arminesweeper/Minesweeper2026/Minesweeper2026/Files/Schematic/IMG-20260618-WA0007.jpg

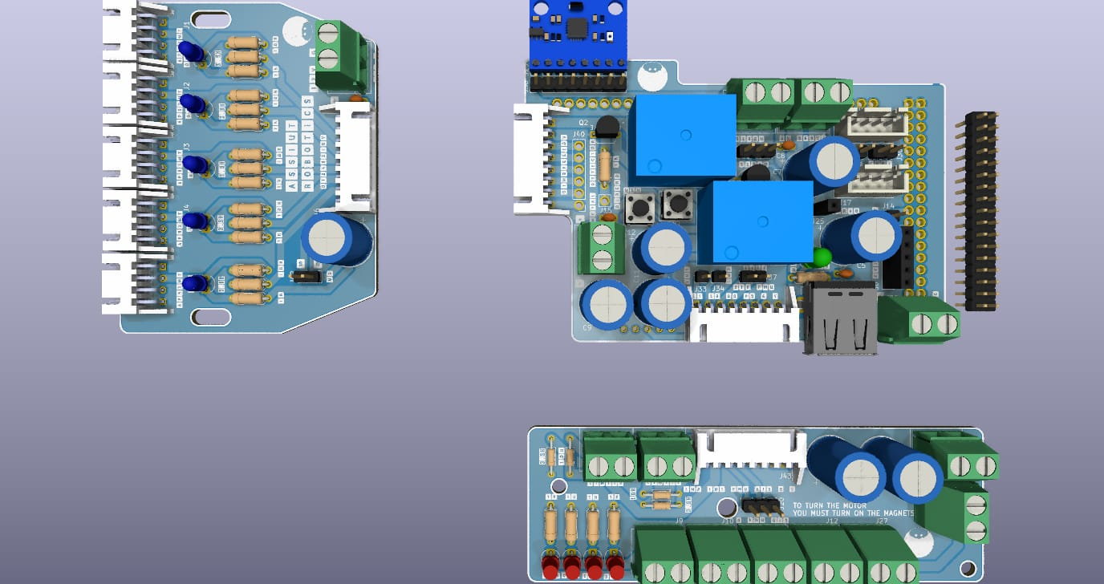
Minesweeper2026/Files/Schematic/IMG-20260618-WA0007.jpg
