arminesweeper/Minesweeper2026/Minesweeper2026/old/Ebda3/Minesweeper_Roport_Ebda3.docx

Project Proposal

الجامعة: جامعة اسيوط | اسم الفريق: Robotics
Minesweeper عنوان الفكرة: | عدد الطلاب ف المشروع : أحمد عرابى محمد محمود أحمد ناصر
الروبوتات والذكاء الاصطناعي | المجال:

فيما لا يزيد عن ٢٥٠ كلمة أكتب وصف عن المشروع باللغة العربية:

في سعينا لتحقيق عالم خالٍ من الألغام، يجب أن يكون لدينا نظام مُصمم بعناية ومُتحكم به بدقة. هذا ما نلتزم بتحقيقه من خلال جهاز كشف الألغام الخاص بنا هذا العام. جهاز كشف الألغام الخاص بنا يتم التحكم فيه باستخدام Raspberry Pi يعمل بحزمة ROS تتألف من عدة عقد، ومواضيع، وخدمات. يمكن للجهاز مسح حقل الألغام، واكتشاف الألغام السطحية وتحت الأرض، وتوليد خريطة توضح مواقع الألغام المكتشفة، وإزالة الألغام السطحية من الحقل.

يتكون النظام من عقد ROS، كل منها مسؤول عن مهمة محددة، وتتواصل هذه العقد مع بعضها البعض لضمان عمل النظام كما هو متوقع.

تلك هي المهام التي يستطيع الروبوت تنفيذها. ولكن كيف يتمكن من تحقيقها؟ كيف يسهم التصميم في هذا الإنجاز؟ ما هي الآليات المختلفة التي تم استخدامها؟ وكيف نتحكم في النظام بأكمله لتحقيق النتائج المرجوة؟ هذه هي الأسئلة التي سنجيب عنها بالتفصيل في هذا التقرير.

أذكر الهدف العام من المشروع والمشكلة التي يقوم هذا المشروع بمعالجتها:

المشكلة: ملايين الأفدنة من الأراضي في مصر (مثل العلمين وسيناء) غير مستغلة بسبب وجود الألغام.

كيف يحل المشروع المشكلة؟

تطهير هذه الأراضي سيمكن من استخدامها في مشروعات زراعية، صناعية، وعمرانية.

توفير مساحات جديدة للاستثمار وتحقيق التنمية المستدامة.
الخسائر البشرية: - الألغام تؤدي إلى إصابات ووفيات بين السكان المحليين، خاصة الأطفال والمزارعين
القيود على التنمية الاقتصادية:- الأراضي الملوثة بالألغام تعيق إنشاء مشروعات اقتصادية كبرى (زراعة، سياحة، وصناعة).
حماية البيئة: الألغام تؤدي إلى تدمير البيئة المحلية بسبب الانفجارات العشوائية.
مشكلة البطالة: البطالة مرتفعة في المناطق المتضررة بسبب قلة فرص العمل.
تقليل العبء على الحكومة: إزالة الألغام تمثل عبئًا كبيرًا على الحكومة بسبب التكلفة العالية والتقنيات المحدودة.
الهدف: نعالج المشكله بإستخدام مزيل الألغام minesweeper والعمل على الفئات المستهدفه لنشر المشروع
المستثمرين
الهيئات الحكومية

أذكر منهجية العمل موضحاً كيفية تحقيق الأهداف ومؤشرات تحقق الأهداف والمخرجات والعوائد من التنفيذ:

الهدف: تطهير مساحات مصر من الألغام لتحقيق الاستفادة منها في التنمية مثل إنشاء مجمعات حضارية.

كيفية تحقيق الأهداف:

أ. البحث والتطوير:

1. تصميم كاشف الألغام:
  - استخدام تقنيات متقدمة مثل:
    - أجهزة استشعار كهرومغناطيسية (Electromagnetic sensors).
    - التصوير بالرادار تحت الأرض (Ground Penetrating Radar - GPR).
    - تحليل البيانات باستخدام الذكاء الاصطناعي لتحسين دقة الكشف.
2. اختبار النظام:
  - اختبار الأجهزة في بيئات مشابهة للحقول المليئة بالألغام لضمان كفاءتها وفعاليتها.

ب. التنفيذ الميداني:

1. تحديد المناطق المستهدفة:
  - استخدام الخرائط الموثقة لمعرفة مواقع الألغام أو المناطق المشبوهة.
  - التعاون مع القوات المسلحة أو الجهات الحكومية للحصول على معلومات دقيقة.
2. تنفيذ التطهير:
  - نشر فريق من المتخصصين باستخدام الأجهزة.
  - توفير إجراءات السلامة والوقاية لتجنب الأخطار أثناء التنفيذ.

ج. التخطيط للتنمية:

1. إعداد دراسات جدوى:
  - دراسة كيفية استغلال الأراضي المطهرة في التنمية.
  - تحديد أولويات الاستخدام (مجمعات حضارية، مشاريع زراعية، استثمارات صناعية).

3. مؤشرات تحقق الأهداف:

1. مؤشرات أداء قصيرة المدى:
  - عدد الألغام المكتشفة وإزالتها شهريًا.
  - تقارير السلامة المتعلقة بعدم وجود حوادث أثناء عمليات التطهير.
2. مؤشرات أداء طويلة المدى:
  - مساحة الأراضي المطهرة (بالكيلومتر المربع) خلال سنة.
  - نسبة الأراضي المطهرة التي تم استغلالها في مشاريع تنموية.

المخرجات الرئيسية من المشروع والمستفيد النهائي المحتمل:

1.المخرجات:

1. على المدى القصير:
  - تطهير مساحات محددة من الألغام.
  - نشر تقارير دورية توضح التقدم في العمل.
2. على المدى الطويل:
  - توفير أراضٍ صالحة للاستخدام.
  - تقليل المخاطر التي تهدد حياة السكان المحليين.

2. العوائد من التنفيذ:

1. اجتماعية:
  - تحسين جودة الحياة للمجتمعات القريبة من المناطق المطهرة.
  - توفير فرص عمل محلية أثناء وبعد التطهير.
2. اقتصادية:
  - استغلال الأراضي المطهرة في المشاريع التنموية مما يعزز الاقتصاد المحلي والوطني.
  - جذب الاستثمارات الأجنبية والمحلية للمناطق المطهرة.
3. بيئية:
  - تحسين البيئة المحلية من خلال إزالة المخاطر.
4. أمنية:

تقليل التهديدات الأمنية الناتجة عن وجود الألغام

صور النموذج الأولى

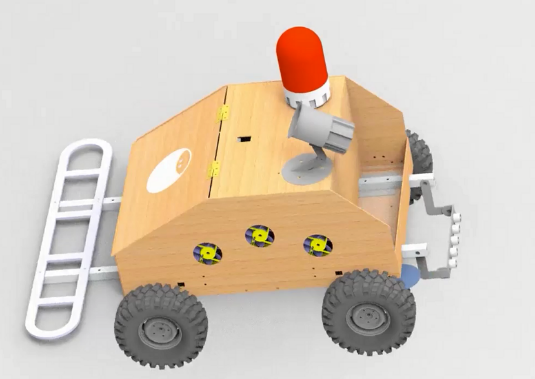
[picture p39: figure]
