arminesweeper/Minesweeper2026/Minesweeper2026/old/Ebda3/New folder/Ebda3 Temp.pdf

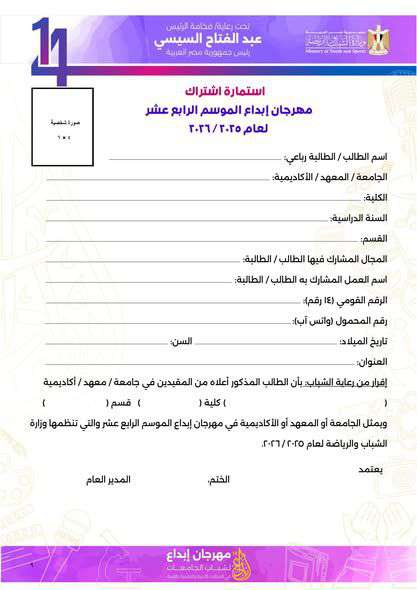
[picture p41: page 1]
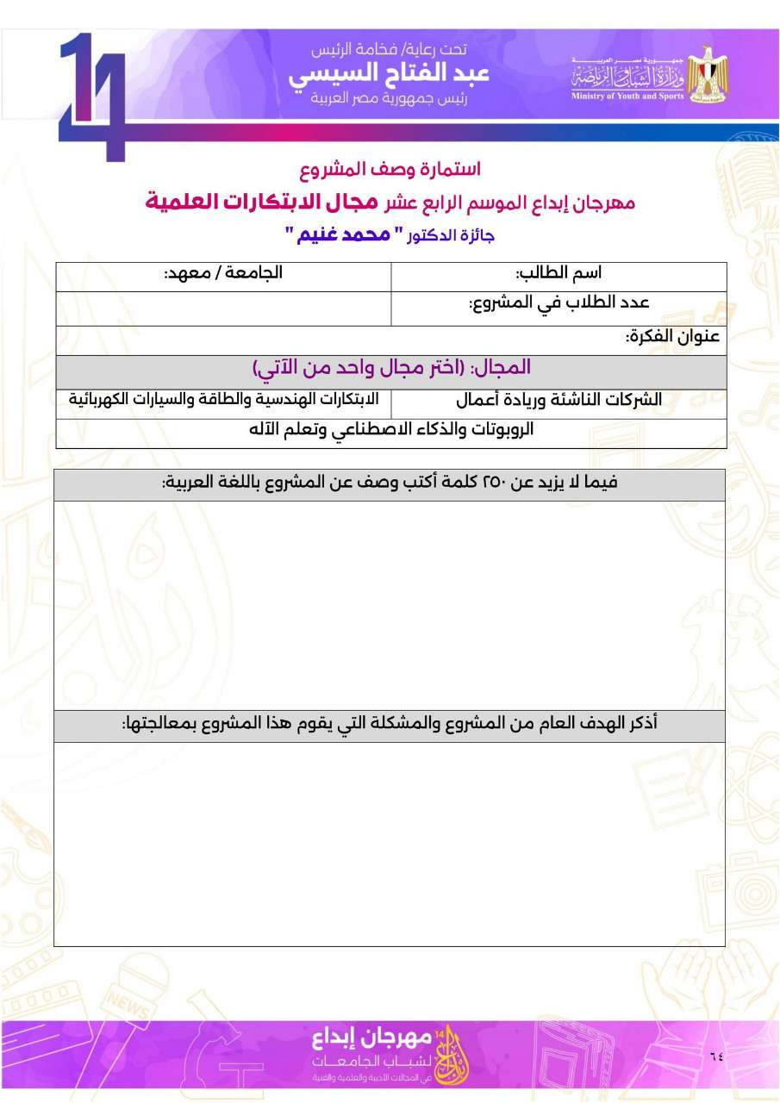
[picture p42: page 2]
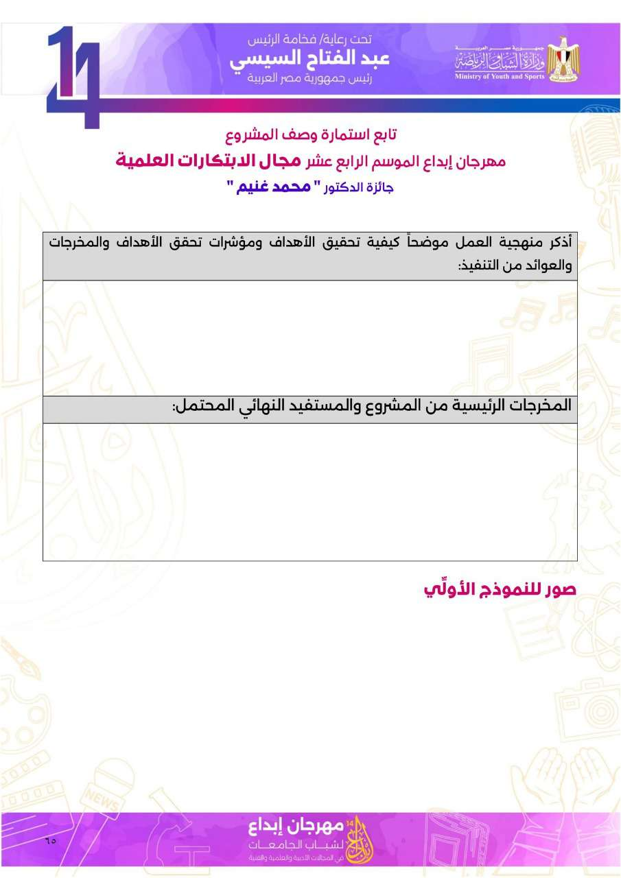
[picture p43: page 3]
