arminesweeper/Minesweeper2026/Minesweeper2026/Files/Schematic/_sch_page_1.png

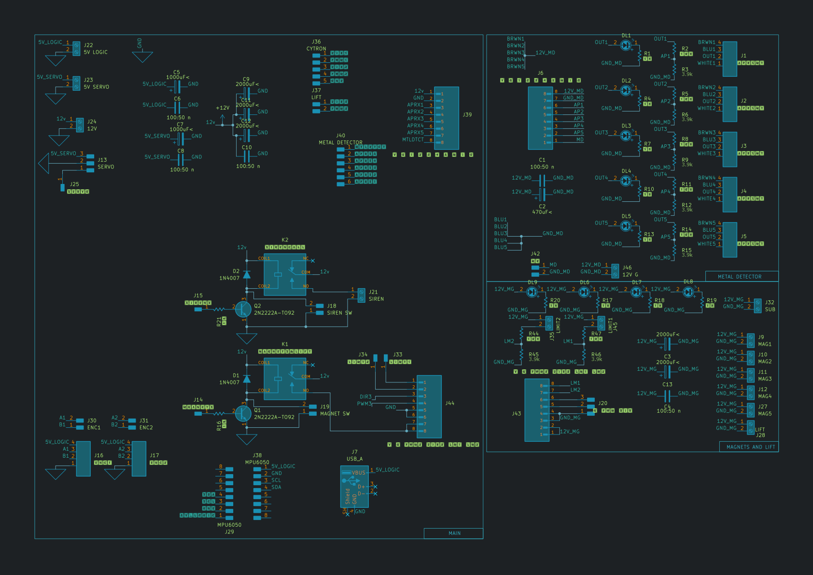
Minesweeper2026/Files/Schematic/_sch_page_1.png
