arminesweeper/Minesweeper2026/Minesweeper2026/Files/mine2026.xlsx

Component | Qty | Unit Cost | Total Cost | Notes | Item
Converter | 1 | 650 | 650 | ROV | https://makerselectronics.com/product/dc-dc-converter-12-24v-to-5v/
ESC | 1 | 850 | 850 | ROV | https://www.op-tronic.com/shop/brushless-driver-esc-2-6s-30a-fvt-littlebee-blheli-s-spring-940
Raspberry Pi 4 8GB | 1 | 9400 | 9400 |  | https://makerselectronics.com/product/raspberry-pi-4-computer-model-b/ | Control
T nuts | 10 | 2 | 20 |  | https://makerselectronics.com/product/flat-m5-t-nut-for-2020-aluminum-extrusions/
Buck Converter | 1 | 120 | 120 |  | https://makerselectronics.com/product/xl4015-adjustable-dc-dc-step-down-module-with-display-5a-75w/ | Power
Mini Push Button Switch 2 Pin 6x6x5mm | 4 | 1 | 4 | لل pcb | View Product ↗ (https://makerselectronics.com/product/mini-push-button-switch-2-pin-6x6x5/)
Mini Push Button 2 Pin 6x6x7.5mm (Long PIN) | 4 | 1 | 4 |  | View Product ↗ (https://makerselectronics.com/product/mini-push-button-2-pin-6x6x7-5mm-lon/)
General Purpose Relay SPDT 12VDC 12A | 4 | 15 | 60 |  | View Product ↗ (https://makerselectronics.com/product/general-purpose-relay-spdt-1-form-c-1/)
B4B-XH-A JST XH 4 Pin Header 2.5mm | 4 | 0.6 | 2.4 |  | View Product ↗ (https://makerselectronics.com/product/b4b-xh-a-jst-xh-4-pin-header-2-5mm/)
S4B-XH-A-1 JST XH Angle 4 Pin Header 2.5mm | 8 | 0.85 | 6.8 |  | View Product ↗ (https://makerselectronics.com/product/s4b-xh-a-1-jst-xh-4-pin-header-2-5mm/)
Ceramic Capacitor 100nF 50V | 10 | 0.5 | 5 |  | View Product ↗ (https://makerselectronics.com/product/ceramic-capacitor-100nf-50v/)
Electrolytic Capacitor 3300uF 35V | 10 | 12 | 120 |  | View Product ↗ (https://makerselectronics.com/product/electrolytic-capacitor-3300uf-35v-16/)
Electrolytic Capacitor 2200uF 35V | 6 | 14 | 84 |  | View Product ↗ (https://makerselectronics.com/product/electrolytic-capacitor-2200uf-35v-16/)
Carbon Resistor 1KΩ 0.25W | 24 | 0.15 | 3.6 |  | View Product ↗ (https://makerselectronics.com/product/carbon-resistor-1k%CF%89-0-25w/)
Carbon Resistor 10KΩ 0.25W (2pcs pack) | 14 | 0.15 | 2.1 |  | View Product ↗ (https://makerselectronics.com/product/2pcs-carbon-resistor-10k%CF%89-0-25w-thr/)
Carbon Resistor 3.9KΩ 0.25W | 14 | 0.15 | 2.1 |  | View Product ↗ (https://makerselectronics.com/product/carbon-resistor-3-9k%CF%89-0-25w-through-hole/)
Round LED 5mm 2Pin (10x Yellow, 2x Blue, 8x Green) | 20 | 0.5 | 10 |  | View Product ↗ (https://makerselectronics.com/product/round-led-5mm-2pin/)
2N2222 NPN Bipolar Transistor 30V 600mA | 4 | 0.75 | 3 |  | View Product ↗ (https://makerselectronics.com/product/2n2222-npn-bipolar-transistor-30v-60/)
Pin Header Male 2.54mm 40-Pin 11mm | 5 | 3 | 15 |  | View Product ↗ (https://makerselectronics.com/product/pin-headers-male-2-54mm-40-pin-straight-black-11mm/)
Pin Header Male 2.54mm 40-Pin 21mm | 5 | 6 | 30 |  | View Product ↗ (https://makerselectronics.com/product/pin-headers-male-2-54mm-40-pin-straight-black-21mm/)
Pin Header Female 2.54mm 40-Pin 11mm | 5 | 5 | 25 |  | View Product ↗ (https://makerselectronics.com/product/pin-headers-female-2-54mm-40-pin/)
USB A Connector PCB Female Type A | 2 | 3 | 6 |  | View Product ↗ (https://makerselectronics.com/product/usb-231-ary-pcb-solder-female-type-a/)
Terminal Block KF2EDGR 5.08 10P | 2 | 25 | 50 |  | View Product ↗ (https://makerselectronics.com/product/terminal-block-kf2edgr-5-08-10p/)
KF128 5.0 2P Green Terminal Block 300V/10A | 28 | 4 | 112 |  | View Product ↗ (https://makerselectronics.com/product/kf128-5-2p-green-terminal-block-300v/)
RM4W Wireless Relay Module 4 CH ESP-12F | 1 | 425 | 425 | تبع صفي هيحاسب عليهم | View Product ↗ (https://makerselectronics.com/product/rm4w-wireless-relay-4-ch-esp-12f/)
Adapter 12V 2A with Dual Jack | 1 | 55 | 55 |  | View Product ↗ (https://makerselectronics.com/product/adapter-12v-2a-with-dual-jack/)
PL2303 USB TTL Converter Module | 1 | 60 | 60 |  | View Product ↗ (https://makerselectronics.com/product/pl2303-usb-ttl-converter-module/)
 |  | Sum | 12125
