arminesweeper/Minesweeper2026/(list of files, cad)

Other CAD files:
Minesweeper2026/old/Ebda3/mine5.obj
