arminesweeper/Minesweeper2026/Minesweeper2026/Schematic/mine_sch.pdf

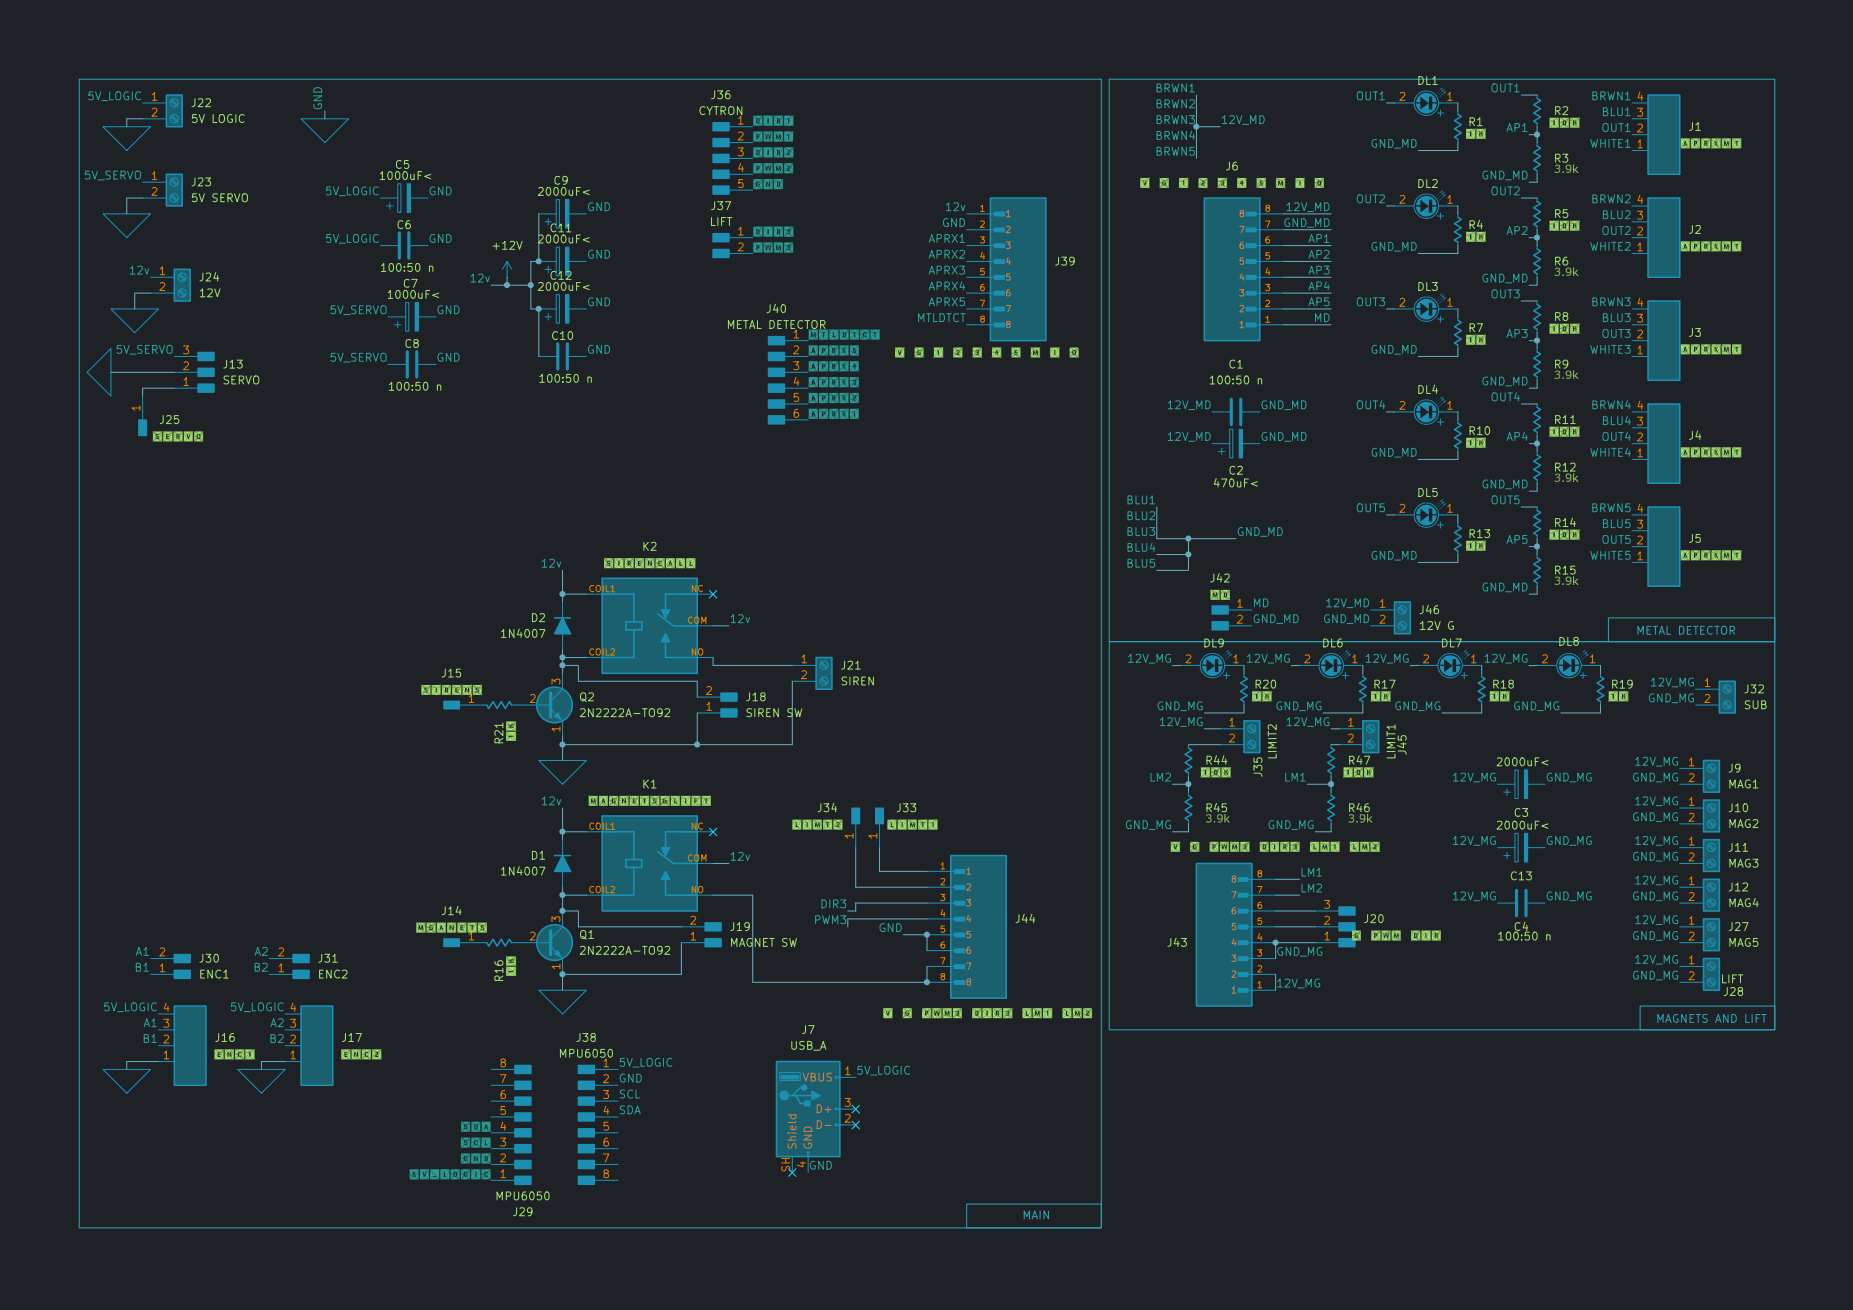
[picture p50: page 1]
