arminesweeper/Minesweeper2026/Minesweeper2026/Schematic/Robotics_Mine.kicad_pcb

## KiCad design Minesweeper2026/Schematic/Robotics_Mine.kicad_pcb (2026-08-05)

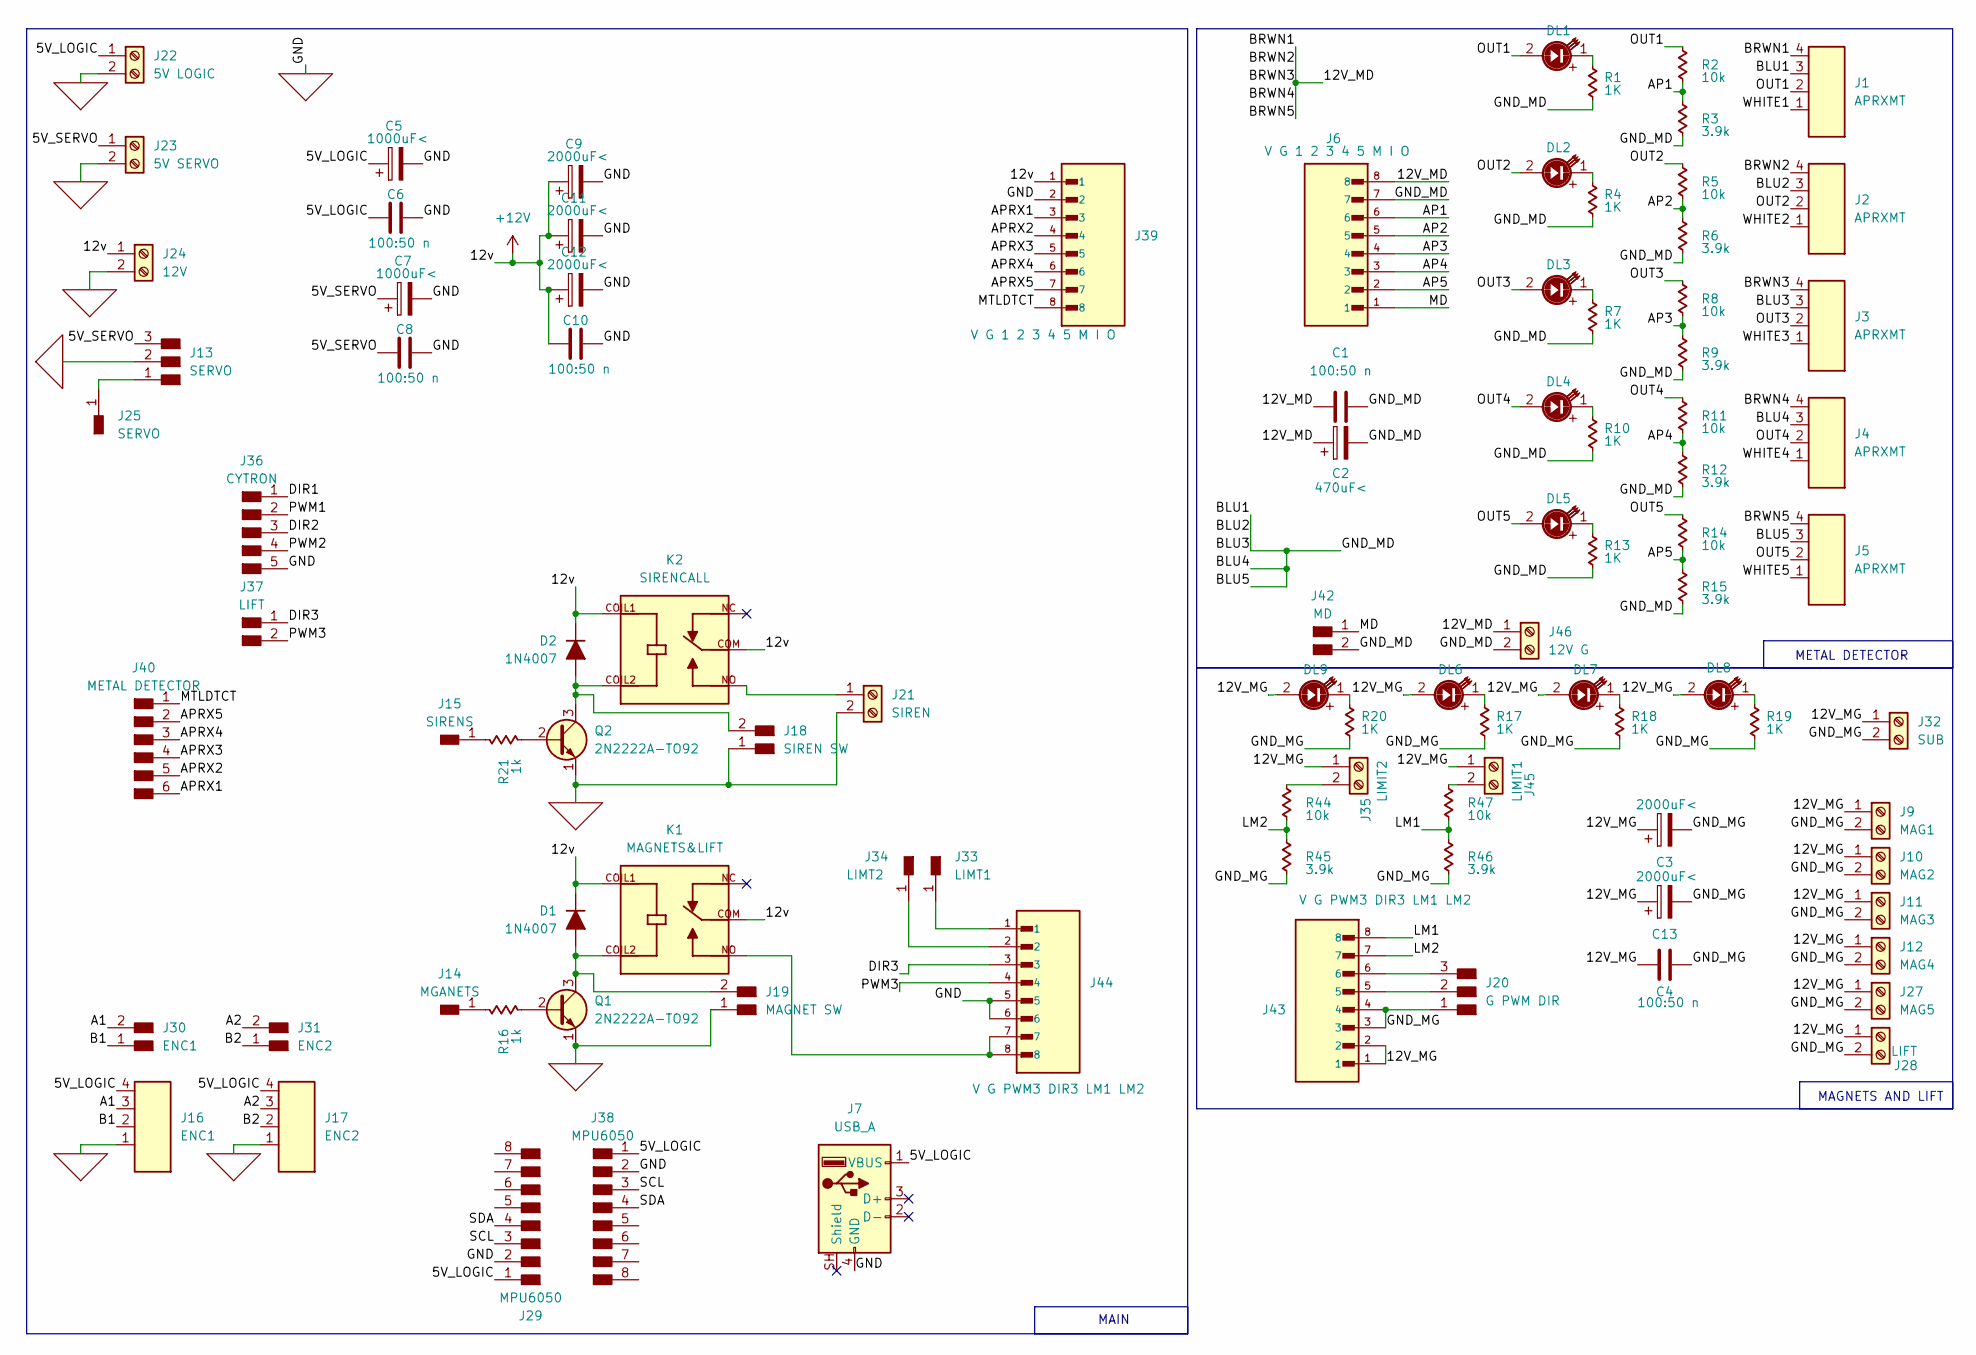
[picture p51: schematic Robotics_Mine.kicad_sch]

Parts:
C1, C4, C6, C8, C10: 100:50 n; C_Disc_D3.0mm_W1.6mm_P2.50mm
C2: 470uF<; CP_Radial_D10.0mm_P5.00mm
C3, C9, C11, C12, C13: 2000uF<; CP_Radial_D10.0mm_P5.00mm
C5, C7: 1000uF<; CP_Radial_D10.0mm_P5.00mm
D1, D2: 1N4007; D_DO-41_SOD81_P7.62mm_Horizontal
DL1, DL2, DL3, DL4, DL5, DL6, DL7, DL8, DL9: LED_D3.0mm
J1, J2, J3, J4, J5: APRXMT; JST_S4B-XH-A
J6, J39: V G 1 2 3 4 5 M I O; JST_S8B-XH-A-1; PARTREV N/A
J7: USB_A; USB_A_Connfly_DS1095
J9: MAG1; TerminalBlock_OnShore_1x02_P5.00mm_Horizontal
J10: MAG2; TerminalBlock_OnShore_1x02_P5.00mm_Horizontal
J11: MAG3; TerminalBlock_OnShore_1x02_P5.00mm_Horizontal
J12: MAG4; TerminalBlock_OnShore_1x02_P5.00mm_Horizontal
J13: SERVO; PinHeader_01x03_P2.54mm_Vertical_THT_D1.4mm
J14: MGANETS; PinHeader_01x01_P2.54mm_Vertical_THT_D1.4mm
J15: SIRENS; PinHeader_01x01_P2.54mm_Vertical_THT_D1.4mm
J16: ENC1; JST_XH_B4B-XH-A_1x04_P2.50mm_Vertical
J17: ENC2; JST_XH_B4B-XH-A_1x04_P2.50mm_Vertical
J18: SIREN SW; PinHeader_01x02_P2.54mm_Vertical_THT_D1.4mm
J19: MAGNET SW; PinHeader_01x02_P2.54mm_Vertical_THT_D1.4mm
J20: G PWM DIR; PinHeader_01x03_P2.54mm_Vertical_THT_D1.4mm
J21: SIREN; TerminalBlock_OnShore_1x02_P5.00mm_Horizontal
J22: 5V LOGIC; TerminalBlock_OnShore_1x02_P5.00mm_Horizontal
J23: 5V SERVO; TerminalBlock_OnShore_1x02_P5.00mm_Horizontal
J24: 12V; TerminalBlock_OnShore_1x02_P5.00mm_Horizontal
J25: SERVO; PinHeader_01x01_P2.54mm_Vertical_THT_D1.4mm
J27: MAG5; TerminalBlock_OnShore_1x02_P5.00mm_Horizontal
J28: LIFT; TerminalBlock_OnShore_1x02_P5.00mm_Horizontal
J29, J38: MPU6050; PinHeader_01x08_P2.54mm_Vertical_THT_D1.4mm
J30: ENC1; PinHeader_01x02_P2.54mm_Vertical_THT_D1.4mm
J31: ENC2; PinHeader_01x02_P2.54mm_Vertical_THT_D1.4mm
J32: SUB; TerminalBlock_OnShore_1x02_P5.00mm_Horizontal
J33: LIMT1; PinHeader_01x01_P2.54mm_Vertical_THT_D1.4mm
J34: LIMT2; PinHeader_01x01_P2.54mm_Vertical_THT_D1.4mm
J35: LIMIT2; TerminalBlock_OnShore_1x02_P5.00mm_Horizontal
J36: CYTRON; PinHeader_01x05_P2.54mm_Vertical_THT_D1mm
J37: LIFT; PinHeader_01x02_P2.54mm_Vertical_THT_D1.4mm
J40: METAL DETECTOR; PinHeader_01x06_P2.54mm_Vertical_THT_D1.4mm
J42: MD; PinHeader_01x02_P2.54mm_Vertical_THT_D1.4mm
J43, J44: V G PWM3 DIR3 LM1 LM2; JST_S8B-XH-A-1; PARTREV N/A
J45: LIMIT1; TerminalBlock_OnShore_1x02_P5.00mm_Horizontal
J46: 12V G; TerminalBlock_OnShore_1x02_P5.00mm_Horizontal
K1: MAGNETS&LIFT; RELAY_SRD-12VDC-SL-C; PARTREV 1.0
K2: SIRENCALL; RELAY_SRD-12VDC-SL-C; PARTREV 1.0
Q1, Q2: 2N2222A-TO92; TO-92_Inline_Wide_EBC
R1, R4, R7, R10, R13, R17, R18, R19, R20: 1K; R_Axial_DIN0207_L6.3mm_D2.5mm_P7.62mm_Horizontal
R2, R5, R8, R11, R14: 10k; R_Axial_DIN0207_L6.3mm_D2.5mm_P7.62mm_Horizontal
R3, R6, R9, R12, R15: 3.9k; R_Axial_DIN0207_L6.3mm_D2.5mm_P7.62mm_Horizontal
R16, R21: 1k; R_Axial_DIN0207_L6.3mm_D2.5mm_P7.62mm_Horizontal
R44, R47: 10k; R_Axial_DIN0204_L3.6mm_D1.6mm_P7.62mm_Horizontal
R45, R46: 3.9k; R_Axial_DIN0204_L3.6mm_D1.6mm_P7.62mm_Horizontal

Connections:
4: J13.1, J25.1 (Pin_1_1)
12: J38.8
13: J38.7
+12V: C9.1, C10.1, C11.1, C12.1, D1.1 (K), D2.1 (K), J24.1, J39.1, K1.COIL1, K1.COM, K2.COIL1, K2.COM
/5V_LOGIC: C5.1, C6.1, J7.1 (VBUS), J16.4, J17.4, J22.1, J29.1, J38.1; also elsewhere on the board
/5V_SERVO: C7.1, C8.1, J13.3, J23.1
/12V_MD: C1.1, C2.1, J1.4, J2.4, J3.4, J4.4, J5.4, J6.8, J46.1
/12V_MG: C3.1, C4.1, C13.1, DL6.2, DL7.2, DL8.2, DL9.2, J9.1, J10.1, J11.1, J12.1, J27.1, J28.1, J32.1, J35.1, J43.1, J43.2, J45.1
/A1: J16.3, J30.2
/A2: J17.3, J31.2
/AP1: J6.6, R2.2 (-), R3.1 (+)
/AP2: J6.5, R5.2 (-), R6.1 (+)
/AP3: J6.4, R8.2 (-), R9.1 (+)
/AP4: J6.3, R11.2 (-), R12.1 (+)
/AP5: J6.2, R14.2 (-), R15.1 (+)
/APRX1: J39.3, J40.6
/APRX2: J39.4, J40.5
/APRX3: J39.5, J40.4
/APRX4: J39.6, J40.3
/APRX5: J39.7, J40.2
/B1: J16.2, J30.1
/B2: J17.2, J31.1
/BLU1: C1.2, C2.2, J1.3, J2.3, J3.3, J4.3, J5.3, J6.7, J42.2, J46.2, R1.2 (-), R3.2 (-), R4.2 (-), R6.2 (-), R7.2 (-), R9.2 (-), R10.2 (-), R12.2 (-), R13.2 (-), R15.2 (-)
/DIR1: J36.1
/DIR2: J36.3
/DIR3: J37.1, J44.3
/GND_MG: C3.2, C4.2, C13.2, J9.2, J10.2, J11.2, J12.2, J20.1, J27.2, J28.2, J32.2, J43.3, J43.4, R17.2 (-), R18.2 (-), R19.2 (-), R20.2 (-), R45.2 (-), R46.2 (-)
/LM1: J43.8, R46.1 (+), R47.2 (-)
/LM2: J43.7, R44.2 (-), R45.1 (+)
/MD: J6.1, J42.1
/MTLDTCT: J39.8, J40.1
/OUT1: DL1.2, J1.2, R2.1 (+)
/OUT2: DL2.2, J2.2, R5.1 (+)
/OUT3: DL3.2, J3.2, R8.1 (+)
/OUT4: DL4.2, J4.2, R11.1 (+)
/OUT5: DL5.2, J5.2, R14.1 (+)
/PWM1: J36.2
/PWM2: J36.4
/PWM3: J37.2, J44.4
/SCL: J29.3, J38.3
/SDA: J29.4, J38.4
/WHITE1: J1.1
/WHITE2: J2.1
/WHITE3: J3.1
/WHITE4: J4.1
/WHITE5: J5.1
unnamed: D1.2 (A), J19.2, K1.COIL2, Q1.3 (C)
unnamed: D2.2 (A), J18.2, K2.COIL2, Q2.3 (C)
unnamed: J14.1 (Pin_1_1), R16.1 (+)
unnamed: J15.1 (Pin_1_1), R21.1 (+)
unnamed: J20.2, J43.5
unnamed: J20.3, J43.6
unnamed: J21.1, K2.NO
unnamed: J33.1 (Pin_1_1), J44.1
unnamed: J34.1 (Pin_1_1), J44.2
unnamed: J35.2, R44.1 (+)
unnamed: J44.7, J44.8, K1.NO
unnamed: J45.2, R47.1 (+)
unnamed: Q1.2 (B), R16.2 (-)
unnamed: Q2.2 (B), R21.2 (-)
unnamed: DL1.1, R1.1 (+)
unnamed: DL2.1, R4.1 (+)
unnamed: DL3.1, R7.1 (+)
unnamed: DL4.1, R10.1 (+)
unnamed: DL5.1, R13.1 (+)
unnamed: DL6.1, R17.1 (+)
unnamed: DL7.1, R18.1 (+)
unnamed: DL8.1, R19.1 (+)
unnamed: DL9.1, R20.1 (+)
P,GND: C5.2, C6.2, C7.2, C8.2, C9.2, C10.2, C11.2, C12.2, J7.4 (GND), J13.2, J16.1, J17.1, J18.1, J19.1, J21.2, J22.2, J23.2, J24.2, J29.2, J36.5, J38.2, J39.2, J44.5, J44.6, Q1.1 (E), Q2.1 (E); also elsewhere on the board

Notes on the sheet:
MAIN
MAGNETS AND LIFT
METAL DETECTOR

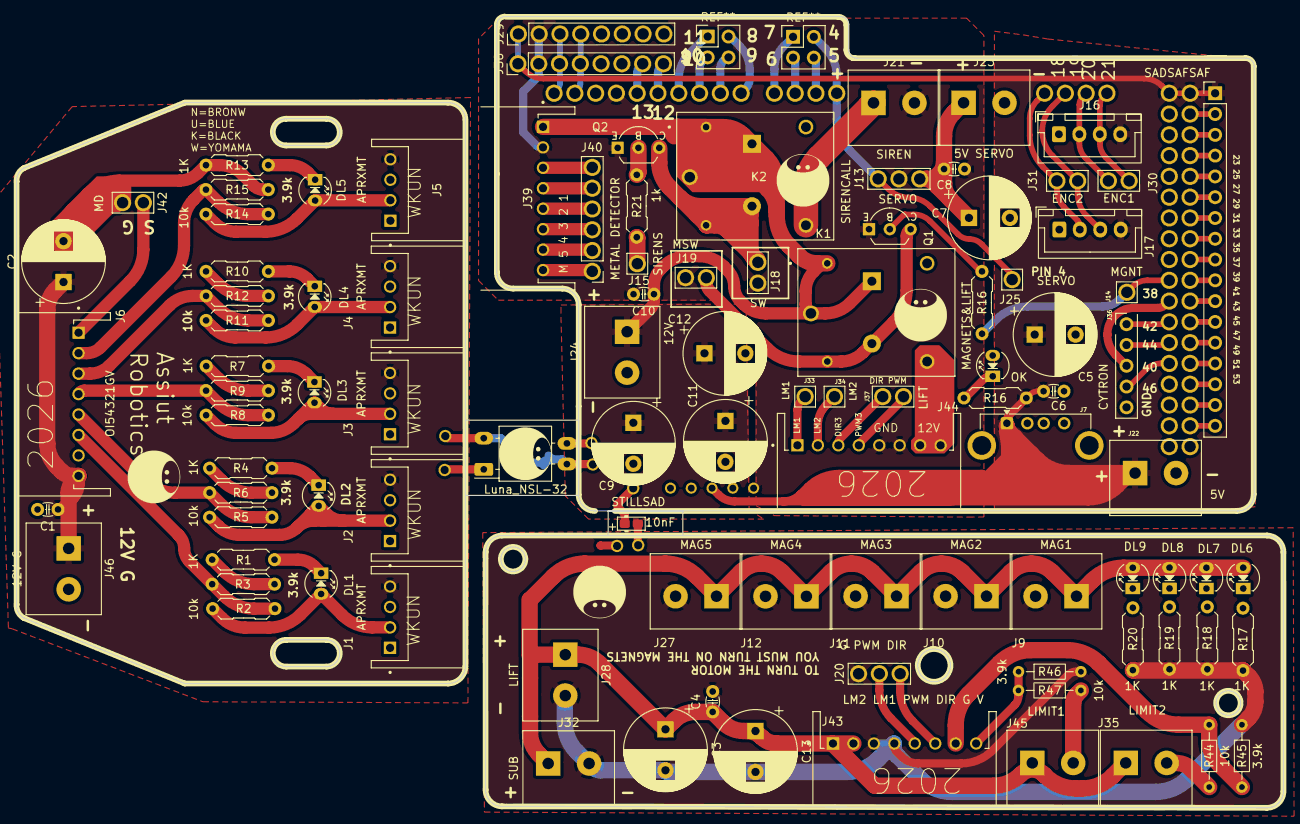
[picture p52: board Robotics_Mine.kicad_pcb from above]

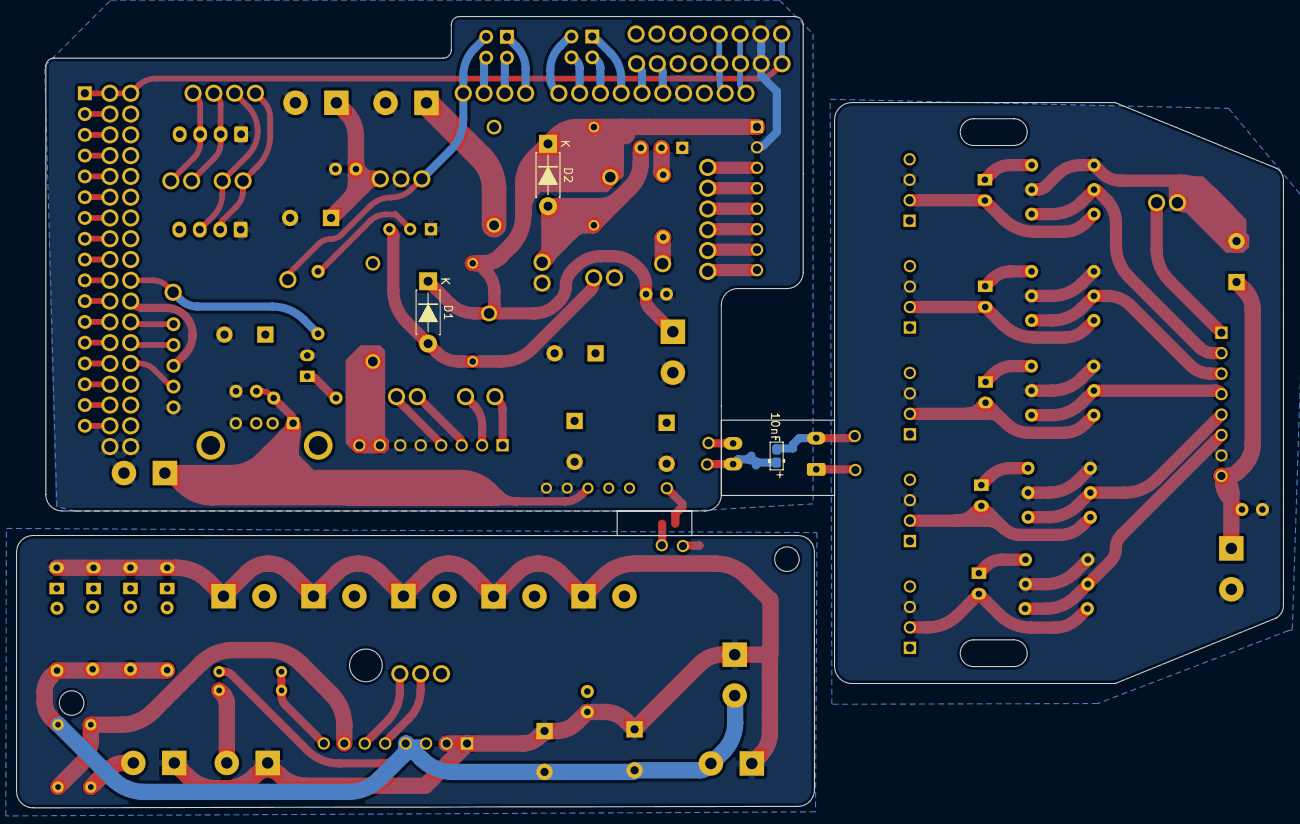
[picture p53: board Robotics_Mine.kicad_pcb from below]

Board: 2 copper layers, 154.8 x 96.7 mm, 99 parts (2 on the bottom side), 60 nets.

Other parts of the board:
OK: LED_D3.0mm
R16#2: 1k; R_Axial_DIN0207_L6.3mm_D2.5mm_P7.62mm_Horizontal
SADSAFSAF: PinHeader_1x17_P2.54mm_Vertical

Their connections:
/5V_LOGIC: R16#2.1 (+), SADSAFSAF.1; also elsewhere on the board
P,GND: OK.2; also elsewhere on the board
red: OK.1, R16#2.2 (-)
