arminesweeper/Minesweeper2026/Minesweeper2026/Arduino/PassthroughCode/PassthroughCode.ino

// void setup() {
//   Serial.begin(115200);  // USB to Computer
//   Serial2.begin(115200); // Connection to ESP8266
// }

// void loop() {
//   // Read from ESP8266 and send to Computer
//   if (Serial2.available()) {
//     Serial.write(Serial2.read());
//   }
//   // Read from Computer and send to ESP8266
//   if (Serial.available()) {
//     Serial2.write(Serial.read());
//   }
// }

void setup() {}

void loop() {}
