arminesweeper/Minesweeper2026/Minesweeper2026/Arduino/MotorController/SystemManager.cpp

/**
 * ============================================================================
 * SYSTEMMANAGER.CPP - Main Orchestrator & Task Scheduler
 * ============================================================================
 */

#include "SystemManager.h"

// Define static members
SafetyMonitor SystemManager::safety_;
SerialProtocol SystemManager::serial_;
MotionController SystemManager::motion_;
Diagnostics SystemManager::diag_;
Odometry SystemManager::odom_;
IMU SystemManager::imu_;
LiftController SystemManager::lift_;
Sensors SystemManager::sensors_;

MotorDriver SystemManager::motorRight_({Pins::MOTOR_R_PWM, Pins::MOTOR_R_DIR}, false);
MotorDriver SystemManager::motorLeft_({Pins::MOTOR_L_PWM, Pins::MOTOR_L_DIR}, true);
MotorDriver SystemManager::motorRight2_({Pins::MOTOR_R_PWM_2, Pins::MOTOR_R_DIR_2}, false);
MotorDriver SystemManager::motorLeft2_({Pins::MOTOR_L_PWM_2, Pins::MOTOR_L_DIR_2}, true);

Encoder SystemManager::encoderRight_({Pins::ENCODER_R_A, Pins::ENCODER_R_B, 2}, false);
Encoder SystemManager::encoderLeft_({Pins::ENCODER_L_A, Pins::ENCODER_L_B, 2}, true);

PIDController SystemManager::pidRight_(PIDTuning::KP_RIGHT, PIDTuning::KI_RIGHT, PIDTuning::KD_RIGHT, 0.0f, PIDTuning::OUTPUT_MIN, PIDTuning::OUTPUT_MAX, Timing::CONTROL_INTERVAL_MS);
PIDController SystemManager::pidLeft_(PIDTuning::KP_LEFT, PIDTuning::KI_LEFT, PIDTuning::KD_LEFT, 0.0f, PIDTuning::OUTPUT_MIN, PIDTuning::OUTPUT_MAX, Timing::CONTROL_INTERVAL_MS);
CameraServo SystemManager::cameraServo_;

void SystemManager::begin() {
    EEPROMManager::init();
    const RobotParameters& params = EEPROMManager::getParams();
    
    Encoder::instance_right_ = &encoderRight_;
    Encoder::instance_left_ = &encoderLeft_;

    motorRight_.setInverted(params.invert_right_motor);
    motorLeft_.setInverted(params.invert_left_motor);
    motorRight2_.setInverted(params.invert_right_motor);
    motorLeft2_.setInverted(params.invert_left_motor);

    motorRight_.begin();
    motorLeft_.begin();
    motorRight2_.begin();
    motorLeft2_.begin();

    encoderRight_.setDirectionInverted(params.invert_right_encoder);
    encoderLeft_.setDirectionInverted(params.invert_left_encoder);
    encoderRight_.begin(Encoder::isrCallbackRight);
    encoderLeft_.begin(Encoder::isrCallbackLeft);

    pidRight_.setTunings(params.kp_right, params.ki_right, params.kd_right, params.ff_right);
    pidLeft_.setTunings(params.kp_left, params.ki_left, params.kd_left, params.ff_left);
#if ENABLE_PID
    pidRight_.begin();
    pidLeft_.begin();
#else
    pidRight_.setEnabled(false);
    pidLeft_.setEnabled(false);
#endif

    serial_.begin();
    motion_.begin();
    diag_.begin();
    odom_.begin();
    
#if ENABLE_IMU
    imu_.begin(params.gyro_bias_x, params.gyro_bias_y, params.gyro_bias_z);
#endif
#if ENABLE_SENSORS
    sensors_.begin();
#endif
#if ENABLE_LIFT || ENABLE_MAGNETS
    lift_.begin();
#endif

    safety_.begin();
    cameraServo_.attach(Pins::SERVO);
    cameraServo_.write(90); // Center position by default

    // Initialize tasks
    tasks_[0] = {"Control", Timing::CONTROL_INTERVAL_MS, 0, 0, taskControlLoop};
    tasks_[1] = {"IMU", Timing::IMU_INTERVAL_MS, 0, 0, taskIMU};
    tasks_[2] = {"Sensors", Timing::SENSOR_INTERVAL_MS, 0, 0, taskSensors};
    tasks_[3] = {"Lift", Timing::LIFT_INTERVAL_MS, 0, 0, taskLift};
    tasks_[4] = {"Hi_Telem", Timing::TELEMETRY_INTERVAL_MS, 0, 0, taskHighRateTelemetry}; // 10 Hz (100 ms)
    tasks_[5] = {"Lo_Telem", 500, 0, 0, taskLowRateTelemetry}; // 2 Hz
    tasks_[6] = {"Diag", 1000, 0, 0, taskDiagnostics}; // 1 Hz
}

void SystemManager::update() {
    diag_.loopStart();
    safety_.resetWatchdog();

    // Process serial input (Non-blocking)
    float r_vel = 0.0f, l_vel = 0.0f, g_vel = 0.0f, s_angle = -1.0f;
    bool has_g_cmd = false;
    if (serial_.processInput(r_vel, l_vel, g_vel, has_g_cmd, s_angle)) {
        motion_.setRightTarget(r_vel);
        motion_.setLeftTarget(l_vel);

#if ENABLE_LIFT
        // Direct joystick velocity control of gripper (gp / gn from ROS teleop)
        if (has_g_cmd) {
            lift_.handleVelocityCommand(g_vel);
        }
#endif

        // If servo angle commanded (0 to 180 degrees)
        if (s_angle >= 0.0f && s_angle <= 180.0f) {
            cameraServo_.write(static_cast<int>(s_angle));
        }

        diag_.incrementCommandCount();
        if (safety_.getState() == SystemState::FAULT && !safety_.hasFault()) {
            safety_.clearFaults();
        }
        if (safety_.getState() != SystemState::ESTOP && safety_.getState() != SystemState::SHUTDOWN) {
            safety_.forceState(SystemState::RUNNING);
        }
    }
    processExtendedCommands();

    uint32_t now = millis();
    
    // Cooperative Scheduler execution
    for (int i = 0; i < 7; i++) {
        if (now - tasks_[i].last_run_ms >= tasks_[i].period_ms) {
            tasks_[i].last_run_ms = now;
            
            uint32_t t_start = micros();
            tasks_[i].callback();
            uint32_t dt = micros() - t_start;
            
            if (dt > tasks_[i].max_execution_time_us) {
                tasks_[i].max_execution_time_us = dt;
            }
        }
    }
    
    // Update Safety Machine
#if ENABLE_SAFETY_MONITOR
    SystemState next_state = safety_.update(serial_.getLastCommandTime(),
                                            motion_.getRightState().measured_velocity,
                                            motion_.getLeftState().measured_velocity,
                                            motorRight_.getOutput(),
                                            motorLeft_.getOutput());
#else
    safety_.forceState(SystemState::RUNNING);
#endif
    
    handleStateTransitions();
    diag_.loopEnd();
}

void SystemManager::taskControlLoop() {
    static uint32_t last_control_us = 0;
    uint32_t now_us = micros();
    float dt = (last_control_us > 0) ? (now_us - last_control_us) * 1e-6f : (Timing::CONTROL_INTERVAL_MS / 1000.0f);
    last_control_us = now_us;

    // Guard against abnormal dt spikes under scheduler anomalies
    if (dt < 0.005f) dt = 0.005f;
    if (dt > 0.100f) dt = 0.100f;
    
    if (millis() - serial_.getLastCommandTime() > SafetyConfig::COMMAND_TIMEOUT_MS) {
        motion_.setRightTarget(0.0f);
        motion_.setLeftTarget(0.0f);
    }
    
    float rad_per_pulse = EEPROMManager::getParams().rad_per_pulse;
    float right_meas_vel = encoderRight_.calculateVelocity(encoderRight_.getPulsesAndReset(), dt, rad_per_pulse);
    float left_meas_vel = encoderLeft_.calculateVelocity(encoderLeft_.getPulsesAndReset(), dt, rad_per_pulse);
    
    motion_.getRightStateMutable().measured_velocity = right_meas_vel;
    motion_.getLeftStateMutable().measured_velocity = left_meas_vel;
    
    motion_.updateProfiles(dt);
    
#if ENABLE_PID
    if (pidRight_.isEnabled() && pidLeft_.isEnabled()) {
        motion_.getRightStateMutable().target_pwm = pidRight_.compute(motion_.getRightState().profiled_velocity, right_meas_vel);
        motion_.getLeftStateMutable().target_pwm = pidLeft_.compute(motion_.getLeftState().profiled_velocity, left_meas_vel);
    } else {
        const RobotParameters& params = EEPROMManager::getParams();
        float pwm_scale = (params.max_velocity > 0.0f) ? (255.0f / params.max_velocity) : 25.5f;
        float target_r_pwm = motion_.getRightState().profiled_velocity * pwm_scale;
        float target_l_pwm = motion_.getLeftState().profiled_velocity * pwm_scale;
        if (target_r_pwm > 255.0f) target_r_pwm = 255.0f;
        else if (target_r_pwm < -255.0f) target_r_pwm = -255.0f;
        if (target_l_pwm > 255.0f) target_l_pwm = 255.0f;
        else if (target_l_pwm < -255.0f) target_l_pwm = -255.0f;
        motion_.getRightStateMutable().target_pwm = target_r_pwm;
        motion_.getLeftStateMutable().target_pwm = target_l_pwm;
    }
#else
    const RobotParameters& params = EEPROMManager::getParams();
    float pwm_scale = (params.max_velocity > 0.0f) ? (255.0f / params.max_velocity) : 25.5f;
    float target_r_pwm = motion_.getRightState().profiled_velocity * pwm_scale;
    float target_l_pwm = motion_.getLeftState().profiled_velocity * pwm_scale;
    if (target_r_pwm > 255.0f) target_r_pwm = 255.0f;
    else if (target_r_pwm < -255.0f) target_r_pwm = -255.0f;
    if (target_l_pwm > 255.0f) target_l_pwm = 255.0f;
    else if (target_l_pwm < -255.0f) target_l_pwm = -255.0f;
    motion_.getRightStateMutable().target_pwm = target_r_pwm;
    motion_.getLeftStateMutable().target_pwm = target_l_pwm;
#endif

    motion_.updatePWM(dt);
    
    if (safety_.isRunning() || safety_.getState() == SystemState::READY) {
        motorRight_.setOutput(motion_.getRightState().current_pwm);
        motorLeft_.setOutput(motion_.getLeftState().current_pwm);
        motorRight2_.setOutput(motion_.getRightState().current_pwm);
        motorLeft2_.setOutput(motion_.getLeftState().current_pwm);
    } else {
        motorRight_.emergencyStop();
        motorLeft_.emergencyStop();
        motorRight2_.emergencyStop();
        motorLeft2_.emergencyStop();
    }
    
    odom_.update(right_meas_vel, left_meas_vel, dt);
    diag_.incrementControlCycleCount();
}

void SystemManager::taskIMU() {
#if ENABLE_IMU
    float dt = Timing::IMU_INTERVAL_MS / 1000.0f;
    imu_.update(dt);
    safety_.setIMUFault(imu_.hasError());
#endif
}

void SystemManager::taskSensors() {
#if ENABLE_SENSORS
    static bool last_mine_detected = false;
    static bool last_metal = false;

    sensors_.update();

    bool current_metal = sensors_.isMetalDetected();
    bool current_prox = sensors_.isAnyProximityTriggered();
    bool current_us = sensors_.isObjectDetected();
    bool mine_detected = current_metal || current_prox || current_us;

    if (current_metal != last_metal) {
        serial_.sendMetalDetect(current_metal);
        last_metal = current_metal;
    }

    if (mine_detected && !last_mine_detected) {
        sensors_.setBuzzerPattern(BuzzerPattern::MINE_DETECT);
    } else if (!mine_detected && last_mine_detected) {
        sensors_.setBuzzerPattern(BuzzerPattern::SILENT);
    }

    last_mine_detected = mine_detected;
#endif
}

void SystemManager::taskLift() {
#if ENABLE_LIFT || ENABLE_MAGNETS
    LiftState prev_state = lift_.getState();
    uint8_t prev_mag = lift_.getMagnetState();
    bool prev_top = lift_.isTopSwitchRaw();
    bool prev_bot = lift_.isBottomSwitchRaw();
#if ENABLE_SENSORS
    bool metal_detected = sensors_.isMetalDetected();
    bool obj_detected = sensors_.isObjectDetected();
    bool prox_detected = sensors_.isAnyProximityTriggered();
    bool mine_detected = metal_detected || obj_detected || prox_detected;
#else
    bool metal_detected = false;
    bool obj_detected = false;
    bool mine_detected = false;
#endif
    lift_.update(obj_detected, mine_detected);
    safety_.setLiftFault(lift_.hasFault());
    bool curr_top = lift_.isTopSwitchRaw();
    bool curr_bot = lift_.isBottomSwitchRaw();
    if (lift_.getState() != prev_state || lift_.getMagnetState() != prev_mag ||
        curr_top != prev_top || curr_bot != prev_bot) {
        serial_.sendLiftState(lift_.getStateString(), lift_.getMagnetState(), curr_top, curr_bot);
    }
#endif
}

void SystemManager::taskHighRateTelemetry() {
#if ENABLE_LIFT
    char gripper_state = 'm'; // default intermediate / moving when neither switch is engaged
    if (lift_.isAtTop()) {
        gripper_state = 'o';
    } else if (lift_.isAtBottom()) {
        gripper_state = 'c';
    } else if (lift_.isCycling()) {
        gripper_state = 'm';
    }
#else
    char gripper_state = 'c';
#endif
#if ENABLE_SENSORS
    bool prox_triggered = sensors_.isAnyProximityTriggered();
    bool metal_detected = sensors_.isMetalDetected();
#else
    bool prox_triggered = false;
    bool metal_detected = false;
#endif
    serial_.sendTelemetry(motion_.getRightState().measured_velocity,
                          motion_.getLeftState().measured_velocity,
                          prox_triggered,
                          metal_detected,
                          gripper_state,
                          encoderRight_.getTotalPulses(),
                          encoderLeft_.getTotalPulses());
}

void SystemManager::taskLowRateTelemetry() {
    static uint8_t phase = 0;
    phase = (phase + 1) % 2;

    // Stagger packets across phases to stay well within the 64-byte serial TX buffer
    if (phase == 0) {
#if ENABLE_ODOMETRY
        serial_.sendOdometry(odom_.getX(), odom_.getY(), odom_.getTheta());
#endif
        serial_.sendBattery(safety_.readBatteryVoltage());
    } else {
#if ENABLE_IMU
        const IMUData& id = imu_.getData();
        serial_.sendIMU(id.yaw, id.pitch, id.roll, id.accel_x, id.accel_y, id.accel_z);
#endif
#if ENABLE_SENSORS
        uint16_t prox[5];
        sensors_.getAllProximity(prox);
        serial_.sendProximity(prox, 5);
        serial_.sendUltrasonic(sensors_.getUltrasonicDistanceCm());
#endif
#if ENABLE_LIFT
        serial_.sendLiftState(lift_.getStateString(), lift_.getMagnetState(), lift_.isTopSwitchRaw(), lift_.isBottomSwitchRaw());
#endif
    }
}

void SystemManager::taskDiagnostics() {
    uint32_t avg_us = diag_.getStats().avg_loop_time_us;
    uint16_t freq = (avg_us > 0) ? (1000000 / avg_us) : 0;
    uint8_t cpu = 0; // CPU usage tracking not implemented
    serial_.sendDiagnostics(freq, cpu, safety_.hasFault() ? 1 : 0);
}

void SystemManager::handleStateTransitions() {
    switch (safety_.getState()) {
        case SystemState::READY:
        case SystemState::RUNNING:
            sensors_.setLEDPattern(LEDPattern::OFF);
            break;
        case SystemState::ESTOP:
            motorRight_.emergencyStop();
            motorLeft_.emergencyStop();
            motorRight2_.emergencyStop();
            motorLeft2_.emergencyStop();
            motion_.emergencyStop();
            sensors_.setLEDPattern(LEDPattern::SLOW_BLINK);
            break;
        case SystemState::FAULT:
        case SystemState::SHUTDOWN:
            motorRight_.emergencyStop();
            motorLeft_.emergencyStop();
            motorRight2_.emergencyStop();
            motorLeft2_.emergencyStop();
            motion_.emergencyStop();
            sensors_.setLEDPattern(LEDPattern::FAST_BLINK);
            break;
        default:
            motorRight_.emergencyStop();
            motorLeft_.emergencyStop();
            motorRight2_.emergencyStop();
            motorLeft2_.emergencyStop();
            break;
    }
}

void SystemManager::processExtendedCommands() {
    char cmd[SerialConfig::CMD_BUFFER_SIZE];
    if (serial_.getExtendedCommand(cmd, sizeof(cmd))) {
        
        // Note: SerialProtocol strips the leading 'C', so "CESTOP" arrives as "ESTOP"
        if (strcmp(cmd, "ESTOP") == 0) safety_.triggerEStop();
        else if (strcmp(cmd, "CLEAR") == 0) {
            safety_.clearEStop();
            safety_.clearFaults();
#if ENABLE_LIFT
            lift_.clearFault();
#endif
            serial_.sendStatus("Faults and E-Stop Cleared");
        }
        else if (strcmp(cmd, "RESET") == 0) {
            safety_.clearEStop();
            safety_.clearFaults();
            odom_.reset();
            imu_.resetYaw();
            diag_.resetStats();
            serial_.sendStatus("Reset complete");
        }
#if ENABLE_LIFT
        else if (strcmp(cmd, "LIFT:UP") == 0) {
            lift_.raise();
            serial_.sendLiftState(lift_.getStateString(), lift_.getMagnetState(), lift_.isTopSwitchRaw(), lift_.isBottomSwitchRaw());
        }
        else if (strcmp(cmd, "LIFT:CYCLE") == 0) {
#if ENABLE_LIFT_AUTO_CYCLES
            lift_.triggerCycle();
#else
            lift_.stop();
            serial_.sendStatus("Lift auto-cycles disabled in config");
#endif
            serial_.sendLiftState(lift_.getStateString(), lift_.getMagnetState(), lift_.isTopSwitchRaw(), lift_.isBottomSwitchRaw());
        }
        else if (strcmp(cmd, "LIFT:DN") == 0) {
            lift_.lower();
            serial_.sendLiftState(lift_.getStateString(), lift_.getMagnetState(), lift_.isTopSwitchRaw(), lift_.isBottomSwitchRaw());
        }
        else if (strcmp(cmd, "LIFT:STOP") == 0) {
            lift_.stop();
            serial_.sendLiftState(lift_.getStateString(), lift_.getMagnetState(), lift_.isTopSwitchRaw(), lift_.isBottomSwitchRaw());
        }
#endif
#if ENABLE_LIFT || ENABLE_MAGNETS
        else if (strcmp(cmd, "MAGNET:ON") == 0) {
#if ENABLE_MAGNETS
            lift_.clearFault();
            lift_.setManualMagnetOverride(true);
            lift_.setAllMagnets(true);
#else
            serial_.sendStatus("Magnets disabled in config");
#endif
            serial_.sendLiftState(lift_.getStateString(), lift_.getMagnetState(), lift_.isTopSwitchRaw(), lift_.isBottomSwitchRaw());
        }
        else if (strcmp(cmd, "MAGNET:OFF") == 0) {
#if ENABLE_MAGNETS
            lift_.setManualMagnetOverride(false);
            lift_.setAllMagnets(false);
#else
            serial_.sendStatus("Magnets disabled in config");
#endif
            serial_.sendLiftState(lift_.getStateString(), lift_.getMagnetState(), lift_.isTopSwitchRaw(), lift_.isBottomSwitchRaw());
        }
#endif
#if ENABLE_SENSORS
        else if (strcmp(cmd, "PROX:ON") == 0) {
            sensors_.setProximityEnabled(true);
            serial_.sendStatus("Proximity Enabled");
        }
        else if (strcmp(cmd, "PROX:OFF") == 0) {
            sensors_.setProximityEnabled(false);
            serial_.sendStatus("Proximity Disabled");
        }
        else if (strcmp(cmd, "BUZZ:ALERT") == 0 || strcmp(cmd, "BUZZ:ON") == 0) sensors_.setBuzzerPattern(BuzzerPattern::ALERT);
        else if (strcmp(cmd, "BUZZ:SILENT") == 0 || strcmp(cmd, "BUZZ:OFF") == 0) sensors_.setBuzzerPattern(BuzzerPattern::SILENT);
#endif
        else if (strncmp(cmd, "SERVO:", 6) == 0) {
            int angle = atoi(cmd + 6);
            if (angle >= 0 && angle <= 180) {
                cameraServo_.write(angle);
            }
        }
        else if (strcmp(cmd, "PID:ON") == 0) {
            pidRight_.setEnabled(true);
            pidLeft_.setEnabled(true);
            serial_.sendStatus("PID Enabled");
        }
        else if (strcmp(cmd, "PID:OFF") == 0) {
            pidRight_.setEnabled(false);
            pidLeft_.setEnabled(false);
            serial_.sendStatus("PID Disabled");
        }
    }
}
