arminesweeper/Minesweeper2026/Minesweeper2026/GUI/app/logging_config.py

"""
Logging configuration for Minesweeper Robot Control Station.
Sets up rotating file logging and clean formatted console output.
"""

import logging
import os
from logging.handlers import RotatingFileHandler
from pathlib import Path


def setup_logging(log_dir: Path | None = None, log_level: int = logging.INFO) -> logging.Logger:
    """Configure root logger with rotating file and console handlers."""
    if log_dir is None:
        log_dir = Path(__file__).resolve().parent.parent / "logs"

    log_dir.mkdir(parents=True, exist_ok=True)
    log_file = log_dir / "minesweeper_station.log"

    root_logger = logging.getLogger()
    root_logger.setLevel(log_level)

    # Avoid duplicate handlers if called multiple times
    if root_logger.handlers:
        return root_logger

    formatter = logging.Formatter(
        fmt="%(asctime)s [%(levelname)8s] (%(threadName)s) %(name)s: %(message)s",
        datefmt="%Y-%m-%d %H:%M:%S",
    )

    # Rotating file handler (5 MB per file, keep 5 backups)
    file_handler = RotatingFileHandler(
        filename=str(log_file),
        maxBytes=5 * 1024 * 1024,
        backupCount=5,
        encoding="utf-8",
    )
    file_handler.setLevel(logging.DEBUG)
    file_handler.setFormatter(formatter)
    root_logger.addHandler(file_handler)

    # Stream/console handler
    console_handler = logging.StreamHandler()
    console_handler.setLevel(log_level)
    console_handler.setFormatter(formatter)
    root_logger.addHandler(console_handler)

    logger = logging.getLogger("ControlStation")
    logger.info("Logging initialized. Output file: %s", log_file)
    return logger
