arminesweeper/Minesweeper2026/(commit log)

2026-06-12 organize Minesweeper2024
    [Functions Discription.xlsx, PinConfig.txt, my_robot.urdf]
2026-07-05 Attach old files, report and arduino code (using LFS for large files)
    [Components Sheet.xlsx, Minesweeper plan 23_24.xlsx, mine2026.xlsx]
2026-07-05 Rename to Ebda3, Adding new arduino code + old code review
    [mine5.obj]
2026-07-05 First batch of the new arduino code with multi-file
2026-07-06 feat(config): update pin definitions and add PID namespace fixes
    [Config.h, MotionController.cpp, PIDController.h]
2026-07-06 feat(hardware): implement IMU, LiftController, and Sensor drivers
2026-07-25 Setup ROS Package
    [bumperbot.urdf.xacro, real_rover_controllers.yaml, rover.urdf.xacro, rover_controllers.yaml, rover_gazebo.xacro, rover_ros2_control.xacro, sim_rover_controllers.yaml]
2026-07-26 Enhance Arduino code + adding presentation and PCB Schematic
2026-08-05 Refactor Arduino code for improved performance and update documentation
    [Robotics_Mine.kicad_pcb, Robotics_Mine.kicad_sch]
2026-08-05 Refactor MotorController code to synchronize with as-fabricated PCB, enhance IMU and encoder handling, and improve lift and sensor functionalities. Update documentation for pin assignments and system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
2026-08-09 docs: add MotorController wiring manual and initialize gitignore
2026-08-10 feat: implement system manager architecture and hardware abstraction for motor controller firmware
2026-08-18 feat: add hardware configuration header and wiring manual for motor controller system
2026-08-18 feat: implement ESP8266-based WiFi controller and motor driver interface architecture
2026-08-21 feat: implement PID controller class and WiFi-based remote control web interface for robot motor management
2026-09-15 feat: enable lift and sensor functionalities, add camera servo control, and enhance WiFi interface with updated HTML and CSS styles
2026-09-15 chore: remove obsolete .history directory from Schematic
2026-09-16 fix: update metal debounce timing and improve command handling in SystemManager; enhance wiring manual with ESP8266 connection details
    [Config.h, SystemManager.cpp]
2026-09-16 feat: add battery monitoring functionality to SerialProtocol and WiFiController; update Config.h for limit switch logic; enhance .gitignore for additional file types
2026-09-16 feat: implement battery status monitoring in WiFiController and SerialProtocol; update Config.h for limit switch logic; enhance .gitignore for additional file types
2026-10-15 docs: add comprehensive testing plan and motor controller firmware implementation
2026-10-15 feat: enhance Serial communication handling with support for Serial2; update ADC sample configuration and improve proximity sensor reading logic
2026-10-15 feat: enhance lift mechanism with automated cycle for mine pickup and drop; add optical sensor support and servo control; update communication protocol for new commands
2026-10-16 feat: update motor control logic and telemetry; refine complementary filter calculations, enhance safety monitoring, and improve communication protocol for gripper state
2026-10-16 feat: implement closed-loop PID control for motor management; add commands to enable/disable PID and update communication documentation
2026-10-16 feat: enhance rover control system with new camera servo functionality, update joystick teleoperation for gripper control, and refine launch configurations for improved modularity
2026-10-16 feat: add isAnyProximityTriggered method to Sensors class for enhanced proximity detection; update SystemManager to utilize new proximity check for mine detection
2026-10-16 feat: introduce new obstacle avoidance algorithm in Sensors class; update rover navigation logic to integrate enhanced detection capabilities
2026-10-16 feat: optimize sensor data processing for improved performance; refine data filtering algorithms and enhance communication efficiency in the Sensors class
2026-10-16 feat: integrate HC-SR04 ultrasonic sensor for mine detection; update LiftController and Sensors classes to utilize ultrasonic data, enhance object detection logic, and refine communication protocols 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
2026-10-16 feat: add UltrasonicPacket support for distance measurement; update ApplicationController and RobotState to handle ultrasonic data, enhance telemetry parsing, and improve GUI feedback for mine detect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
2026-10-16 feat: update siren relay logic and limit switch configuration; change siren activation to Active-LOW and adjust limit switch logic level for improved compatibility with hardware
2026-10-16 feat: update motor controller configurations and logic; adjust limit switch and proximity sensor states for improved compatibility, enhance lift control conditions, and refine safety state management
2026-10-16 feat: update motor controller configurations; change siren relay activation to Active-HIGH, adjust command timeout logic, and refine motor stall detection thresholds for improved safety and compatibi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
2026-10-16 fix: correct limit switch pin assignments and adjust debounce timing for improved reliability; update telemetry logic for accurate gripper state representation
2026-10-16 feat: enhance lift control logic and sensor integration; add metal detector support, adjust magnet activation timing, and refine limit switch configurations for improved operational safety and effici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
2026-10-17 feat: improve lift control system by refining sensor integration and enhancing operational safety; adjust magnet activation timing and limit switch configurations for better performance
2026-10-17 feat: add configuration, lift controller, and system manager for motor control subsystem
2026-10-17 feat: add hardware configuration and sensor driver implementations for motor controller
2026-10-17 feat: add ROS 2 compatible Arduino Mega 2560 firmware for Minesweeper rover
2026-10-17 feat: update motor controller configurations and logic; adjust sensor intervals, add total pulse tracking for encoders, and refine siren activation logic for improved performance and compatibility
2026-10-17 feat: modify motor controller configurations; disable safety monitor, increase telemetry buffer size, and implement direct joystick control for lift velocity to enhance operational flexibility and pe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
2026-10-17 feat: enhance lift controller functionality; adjust lift PWM speed, implement automated cycling for mine pickup/drop, and refine magnet activation logic for improved operational efficiency
2026-10-17 feat: refine lift controller logic and configurations; enable Serial2 communication, adjust lift PWM speed for safety, implement raw limit switch checks, and enhance telemetry with limit switch state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
2026-10-18 feat: enhance motor controller functionality; add proximity sensor configuration, improve lift controller logic for magnet activation timing, and refine sensor integration for better obstacle detecti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
2026-10-23 docs: add comprehensive motor controller documentation, architecture, pinouts, and commissioning guides
2026-10-23 feat: enhance motor controller and lift functionality; update limit switch configurations, improve joystick control logic, and refine serial communication handling for better command processing
2026-10-29 feat: update Minesweeper documentation and enhance motor controller configurations; refine lift and magnet control logic, improve sensor integration, and adjust proximity sensor handling for better d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
